apuder/Programmer-20K/README.md

# Programmer 20K

Web-based programmer for the Tang Primer 20K FPGA.
