apuder/Programmer-20K/kicad/Programmer-20K-ESP/Programmer-20K-ESP.kicad_pcb

## KiCad design kicad/Programmer-20K-ESP/Programmer-20K-ESP.kicad_pcb (2026-01-29)

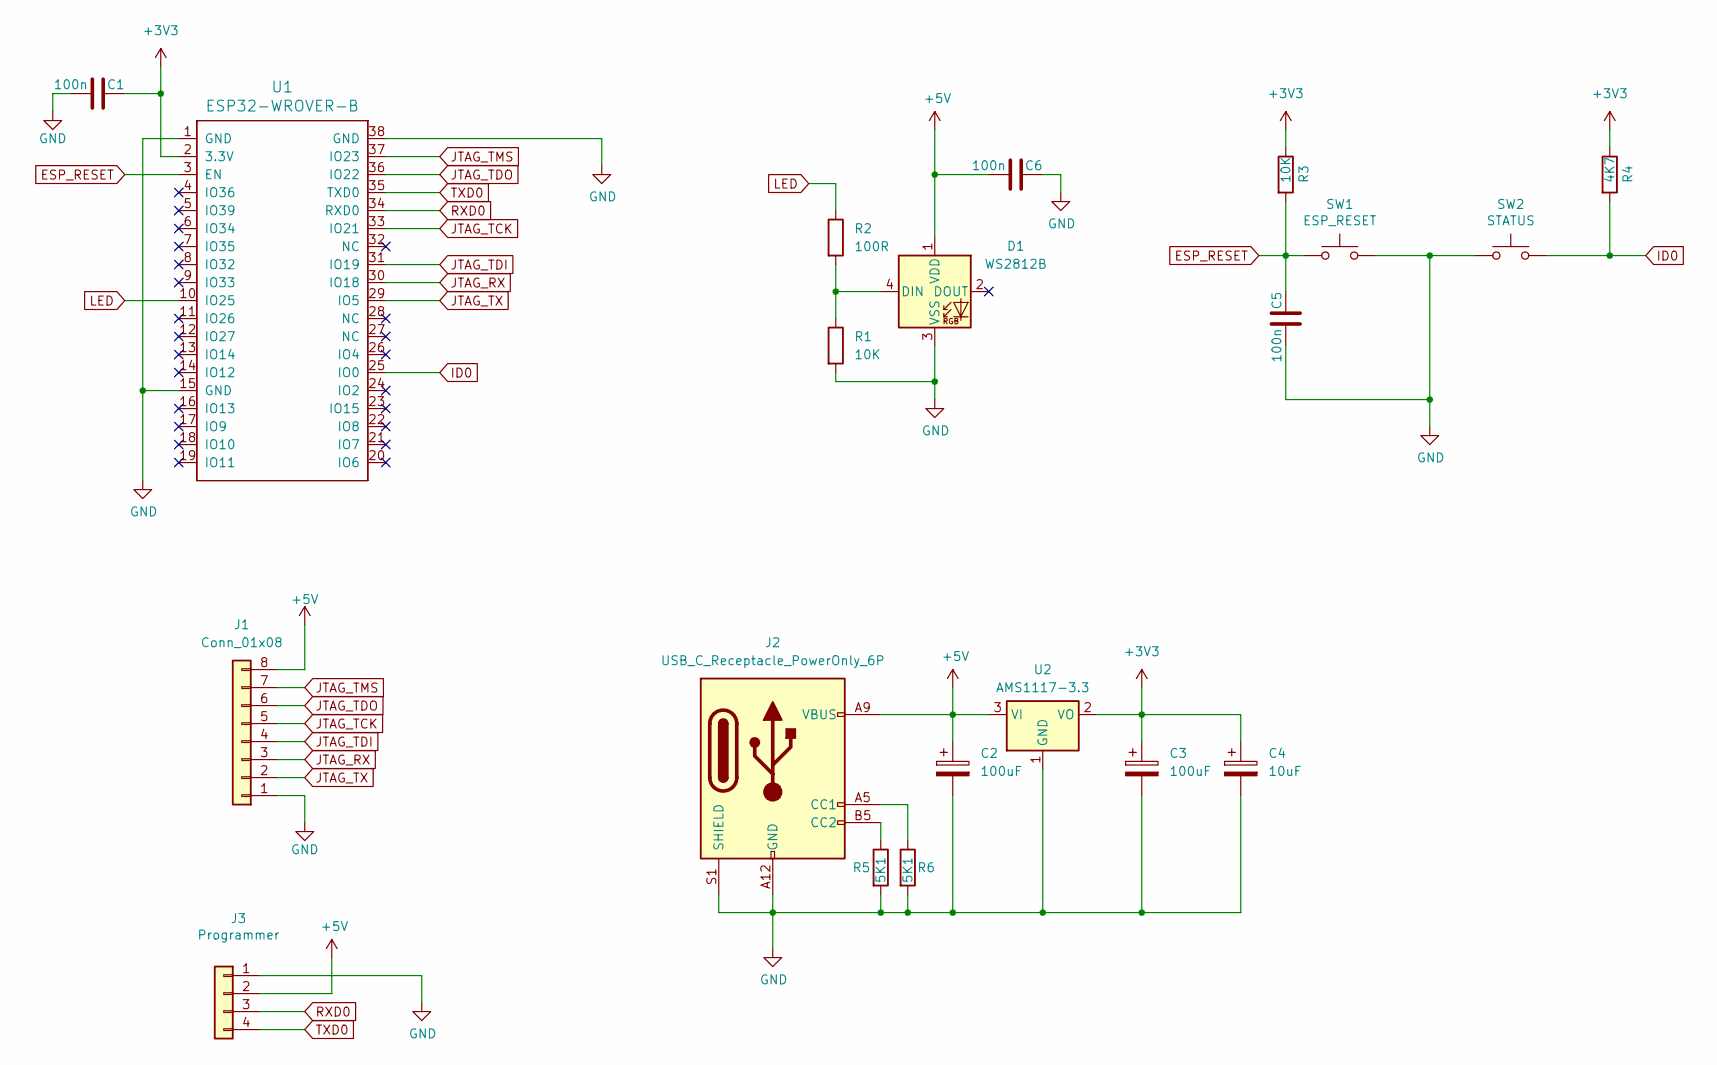
[picture p1: schematic Programmer-20K-ESP.kicad_sch, 20K Programmer]

Parts:
C1, C5, C6: 100n; C_0805_2012Metric_Pad1.18x1.45mm_HandSolder
C2, C3: 100uF; C_1206_3216Metric_Pad1.33x1.80mm_HandSolder; LCSC C1954161
C4: 10uF; C_1206_3216Metric_Pad1.33x1.80mm_HandSolder; LCSC C1952827
D1: WS2812B; LED_WS2812B_PLCC4_5.0x5.0mm_P3.2mm; LCSC C2761795
J1: Conn_01x08; PinHeader_1x08_P2.54mm_Vertical
J2: USB_C_Receptacle_PowerOnly_6P; USB_C_Receptacle_GCT_USB4125-xx-x_6P_TopMnt_Horizontal; LCSC C168701
J3: Programmer; PinHeader_1x04_P2.54mm_Vertical; LCSC C2691448
R1, R3: 10K; R_0805_2012Metric_Pad1.20x1.40mm_HandSolder
R2: 100R; R_0805_2012Metric_Pad1.20x1.40mm_HandSolder
R4: 4K7; R_0805_2012Metric_Pad1.20x1.40mm_HandSolder
R5, R6: 5K1; R_0805_2012Metric_Pad1.20x1.40mm_HandSolder
SW1: ESP_RESET; SW_Push_1P1T_NO_E-Switch_TL3301NxxxxxG; LCSC C255812
SW2: STATUS; SW_Push_1P1T_NO_E-Switch_TL3301NxxxxxG; LCSC C255812
U1: ESP32-WROVER-B; ESP32-WROVER; LCSC C967023
U2: AMS1117-3.3; SOT-223-3_TabPin2

Connections:
+3V3: C1.2, C3.1, C4.1, R3.1, R4.1, U1.2 (3.3V), U2.2 (VO)
+5V: C2.1, C6.1, D1.1 (VDD), J1.8, J2.A9 (VBUS), J2.B9 (VBUS), J3.2, U2.3 (VI)
ESP_RESET: C5.2, R3.2, SW1.1, U1.3 (EN)
GND: C1.1, C2.2, C3.2, C4.2, C5.1, C6.2, D1.3 (VSS), J1.1, J2.A12 (GND), J2.B12 (GND), J2.S1 (SHIELD), J3.1, R1.2, R5.2, R6.2, SW1.2, SW2.1, U1.1 (GND), U1.15 (GND), U1.38 (GND), U2.1 (GND)
ID0: R4.2, SW2.2, U1.25 (IO0)
JTAG_RX: J1.3, U1.30 (IO18)
JTAG_TCK: J1.5, U1.33 (IO21)
JTAG_TDI: J1.4, U1.31 (IO19)
JTAG_TDO: J1.6, U1.36 (IO22)
JTAG_TMS: J1.7, U1.37 (IO23)
JTAG_TX: J1.2, U1.29 (IO5)
LED: R2.1, U1.10 (IO25)
unnamed: D1.4 (DIN), R1.1, R2.2
unnamed: J2.A5 (CC1), R6.1
unnamed: J2.B5 (CC2), R5.1
RXD0: J3.3, U1.34 (RXD0)
TXD0: J3.4, U1.35 (TXD0)

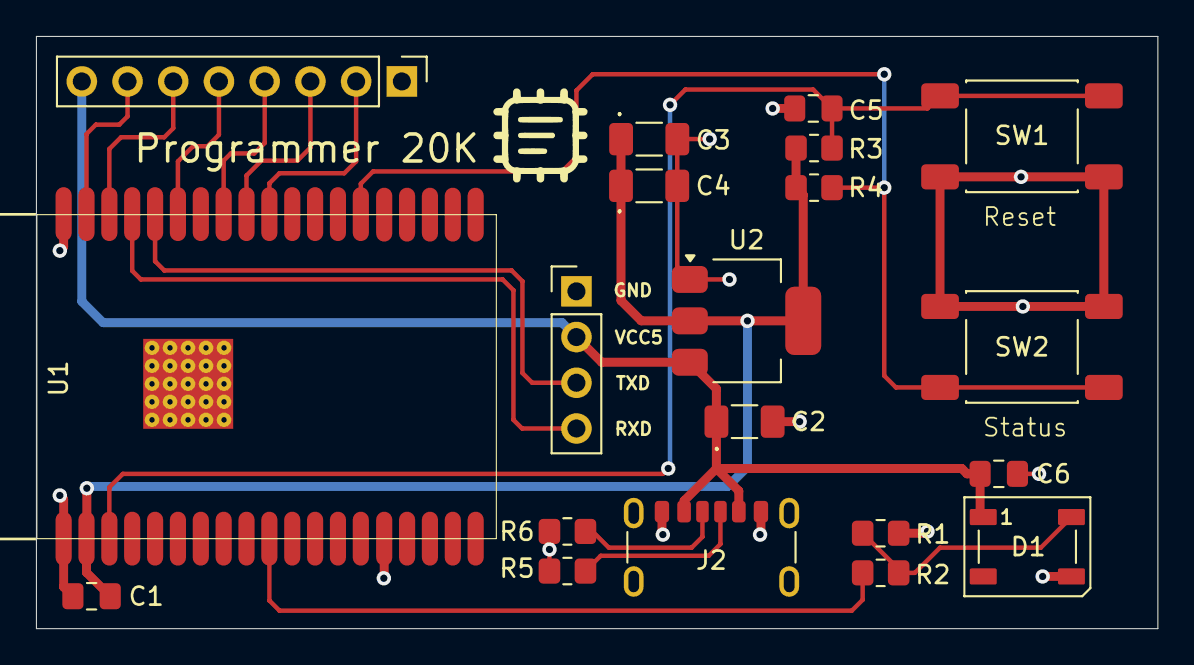
[picture p2: board Programmer-20K-ESP.kicad_pcb from above]

Board: 2 copper layers, 62.3 x 32.9 mm, 20 parts (0 on the bottom side), 17 nets.
