apuder/Programmer-20K/main/include/event.h

#pragma once

#include "freertos/FreeRTOS.h"
#include "freertos/task.h"
#include "freertos/event_groups.h"

#define EVT_WIFI_NOT_INIT      (1 << 0)
#define EVT_WIFI_UP            (1 << 1)
#define EVT_WIFI_DOWN          (1 << 2)
#define EVT_CHECK_20K          (1 << 3)
#define EVT_BUTTON_SHORT_PRESS (1 << 4)
#define EVT_BUTTON_LONG_PRESS  (1 << 5)
#define EVT_UPLOAD_START       (1 << 6)
#define EVT_UPLOAD_SUCCESS     (1 << 7)
#define EVT_UPLOAD_FAIL        (1 << 8)
#define EVT_STOP_UART_MONITOR  (1 << 9)

void evt_signal(EventBits_t bits);
void evt_signal_isr(EventBits_t bits);
EventBits_t evt_wait(EventBits_t bits);
void init_events();
