apuder/Programmer-20K/(commit log)

2025-12-24 Initial version
    [Programmer-20K-ESP.kicad_pcb, Programmer-20K-ESP.kicad_sch]
2025-12-25 Only reboot FPGA when uploading to flash
    [programmer.cpp, upload_receiver.cpp]
2025-12-27 Compact PCB for the programmer
    [Programmer-20K-ESP.kicad_pcb, Programmer-20K-ESP.kicad_sch]
2026-01-29 Support for WS2812B RGB LED
    [Programmer-20K-ESP.kicad_pcb, Programmer-20K-ESP.kicad_sch]
2026-06-01 Fix the wrong RX/TX pins for Programmer20K board
    [serial.h]
2026-06-01 Support for terminal formatting via ESC sequence
2026-06-01 Upgrade to ESP-IDF 6
    [partitions.csv]
